irandms/junior-design/README.md

# junior-design
ECE 341 Junior Design - Final Project - Bluetooth controlled AC switch
