irandms/junior-design/Documents/Block_Diagram_and_Interfaces 1_18_18.pdf

### Block Diagram and Interfaces Bluetooth Controlled AC Switch Group 5: Jesus Narvaez, Spencer Moss and Jacob Ficker

Black Box System:

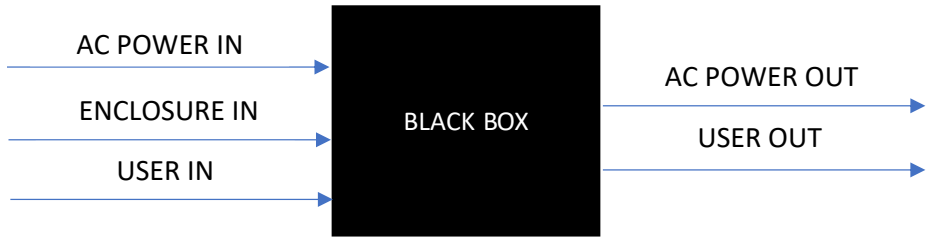
[picture p3: figure]
BLACK BOX; AC POWER IN; ENCLOSURE IN; USER IN; AC POWER OUT; USER OUT

Complete Block Diagram:

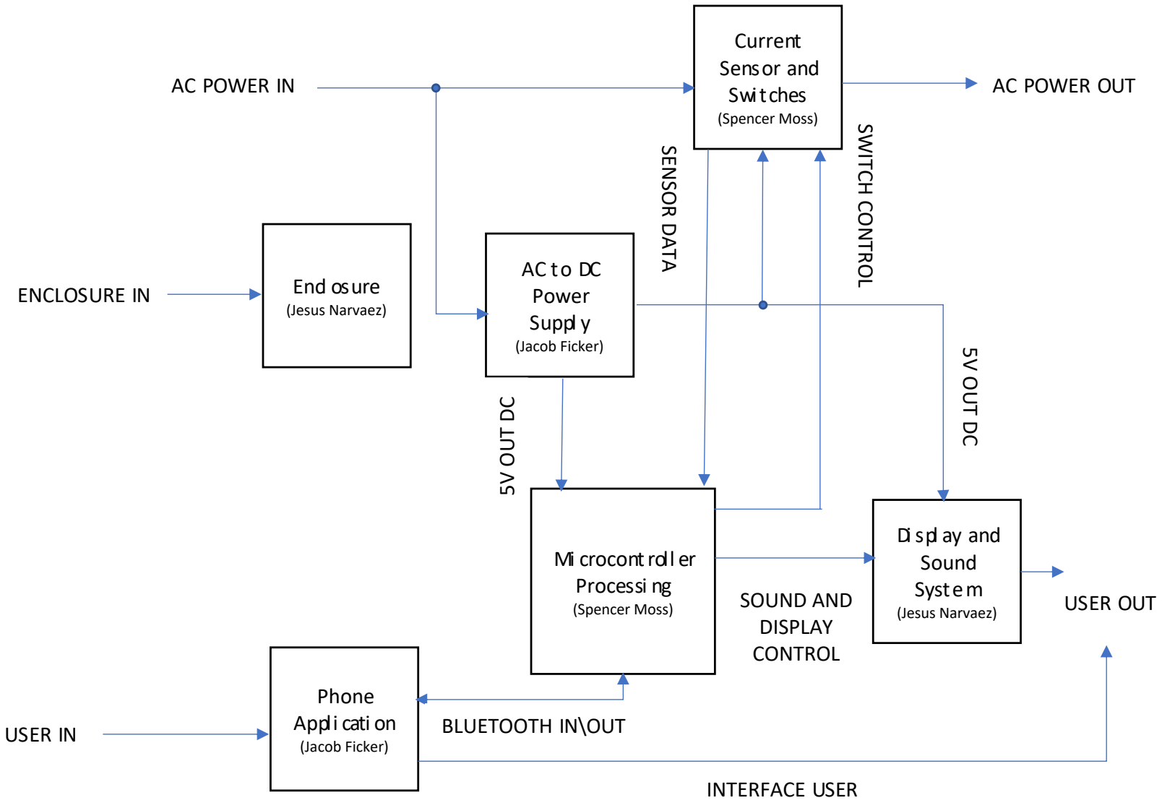
[picture p4: figure]
Phone Appli cati on; (Jacob Ficker); Mi crocont roll er Processi ng; (Spencer Moss); Encl osure; (Jesus Narvaez); Di spl ay and Sound System; AC to DC Power Suppl y; Current Sensor and Switches; USER OUT; AC POWER OUT; USER IN; ENCLOSURE IN; AC POWER IN; BLUETOOTH IN\OUT; INTERFACE USER; 5V OUT DC; SENSOR DATA; SWITCH CONTROL; SOUND AND DISPLAY CONTROL

Interface | Type | Specifics
AC In | AC Power | • Standard U.S. Power • 60 Hz • 120 VAC
AC Out, 2 channels | AC Power | • 60 Hz • 120 VAC • 5 A / 600 W limit on power draw
Enclosure Environment | Environment | • Must not allow any objects larger than 1mm in any dimension inside enclosure. • One master on/off switch
Bluetooth I/O | Digital Data / RF Communication | • IN: One 20 byte packet representing channel state and timer setting. • OUT: One 20 byte packet representing current/power consumption, 10 bytes per channel
User In | App/Display | • Must be considered easily usable by 9/10 people • Successfully transmit data 90% of the time when within range of the device
5V DC Out | DC Power | • Must supply 5V DC • Up to 1.5A DC
Switch Control | Digital Signal | • On/Off 1-bit control signal • 1 signal per output channel (2 total)
Sensor Data | Analog Signal | • Analog 0-5V signal • 2 total signals, 1 per channel
Display + Sound Control | Mixed Signal | • Digital signals to control local display (7-segment displays) of power/current • Small signal AC for audio output (0-5 V)
7-seg + Speaker | Display | • Must create audible noise and readable display for system state and timers • Must make audible sound from at least 10 meters of open space when current limit is triggered.
User Interface | App Display | • Must display current power usage by each channel within 10% • Must update power usage data at least once per minute
User Output | Display | • Displays on/off state of each channel and bluetooth pairing state with 99.9% accuracy.

Interface | Type | Specifics
| | • Displays time remaining on each timer in minutes. This feature must be accurate within five seconds of the actual time remaining.
