irandms/junior-design/ac-switch-board-minimal/ac-switch-board-minimal.pdf

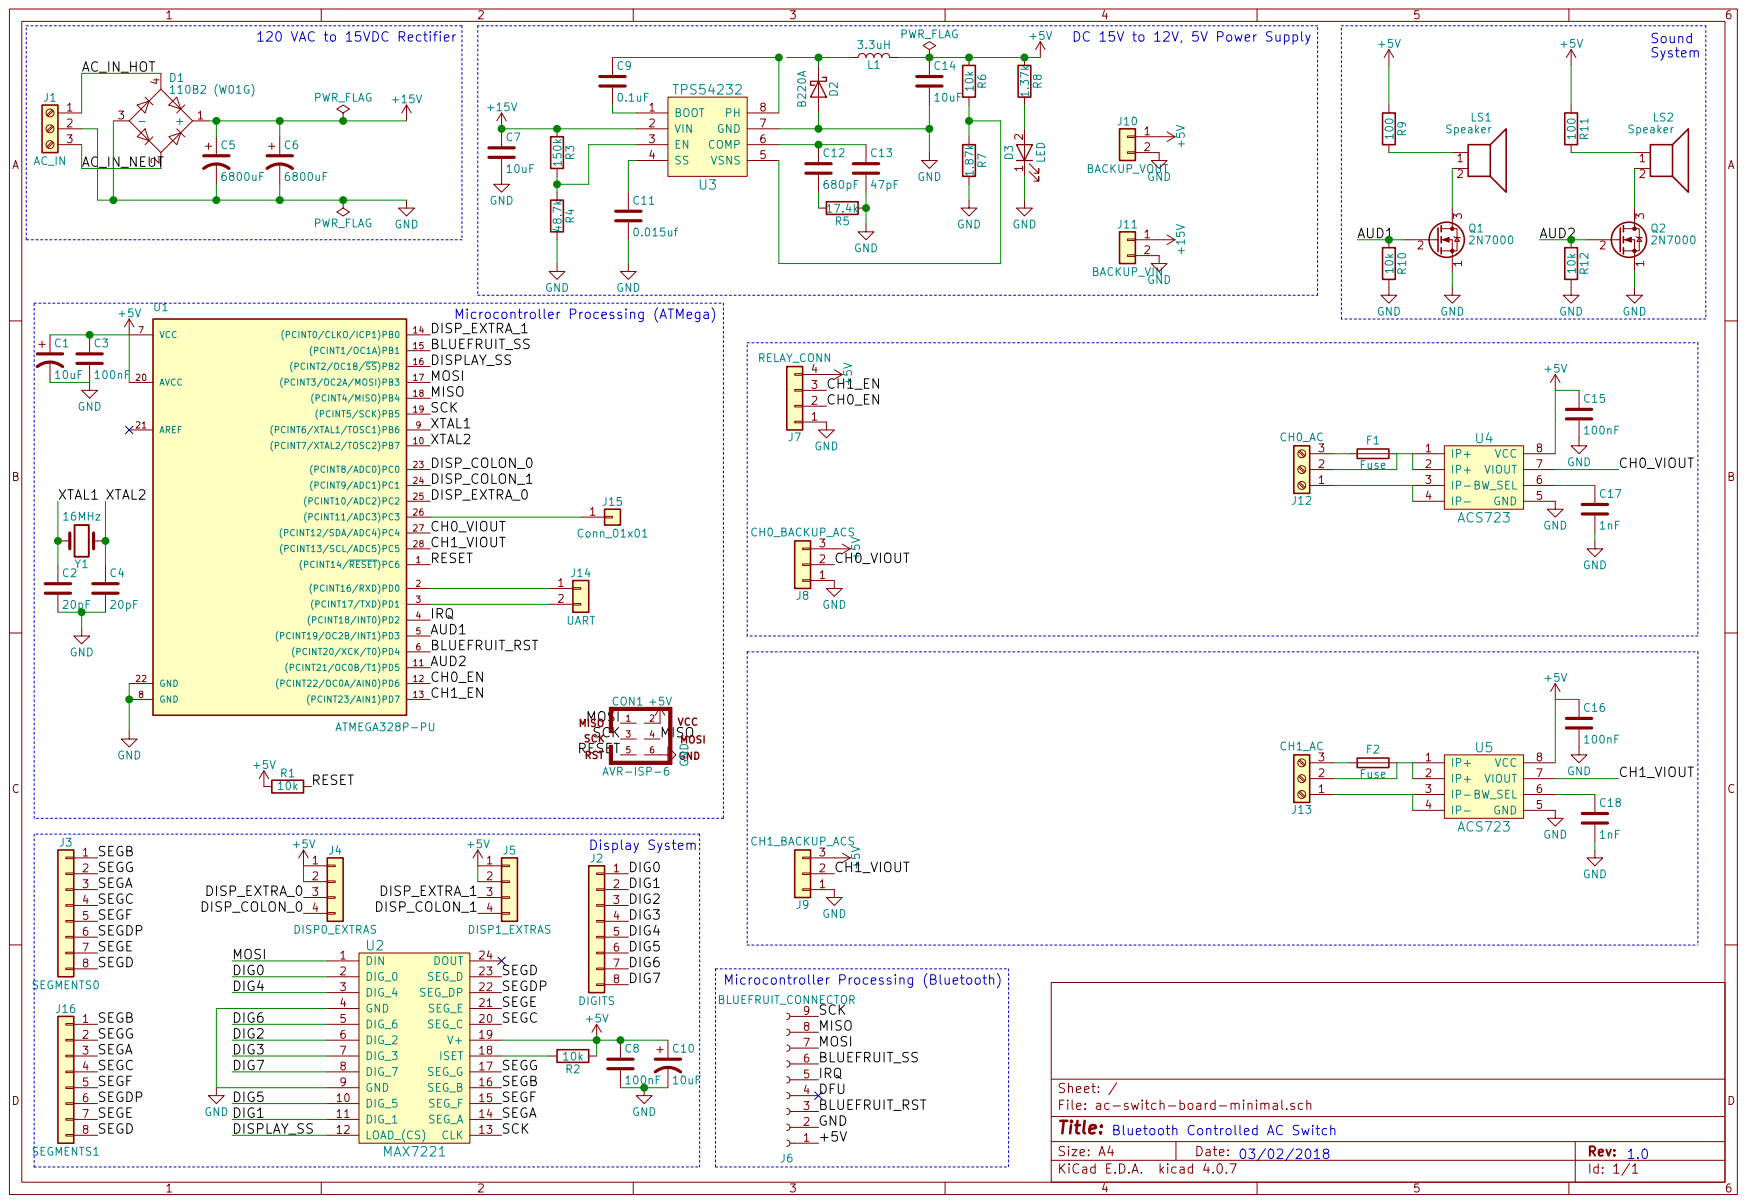
[picture p5: page 1]
