irandms/junior-design/ac-switch-board/ac-switch-board.pdf

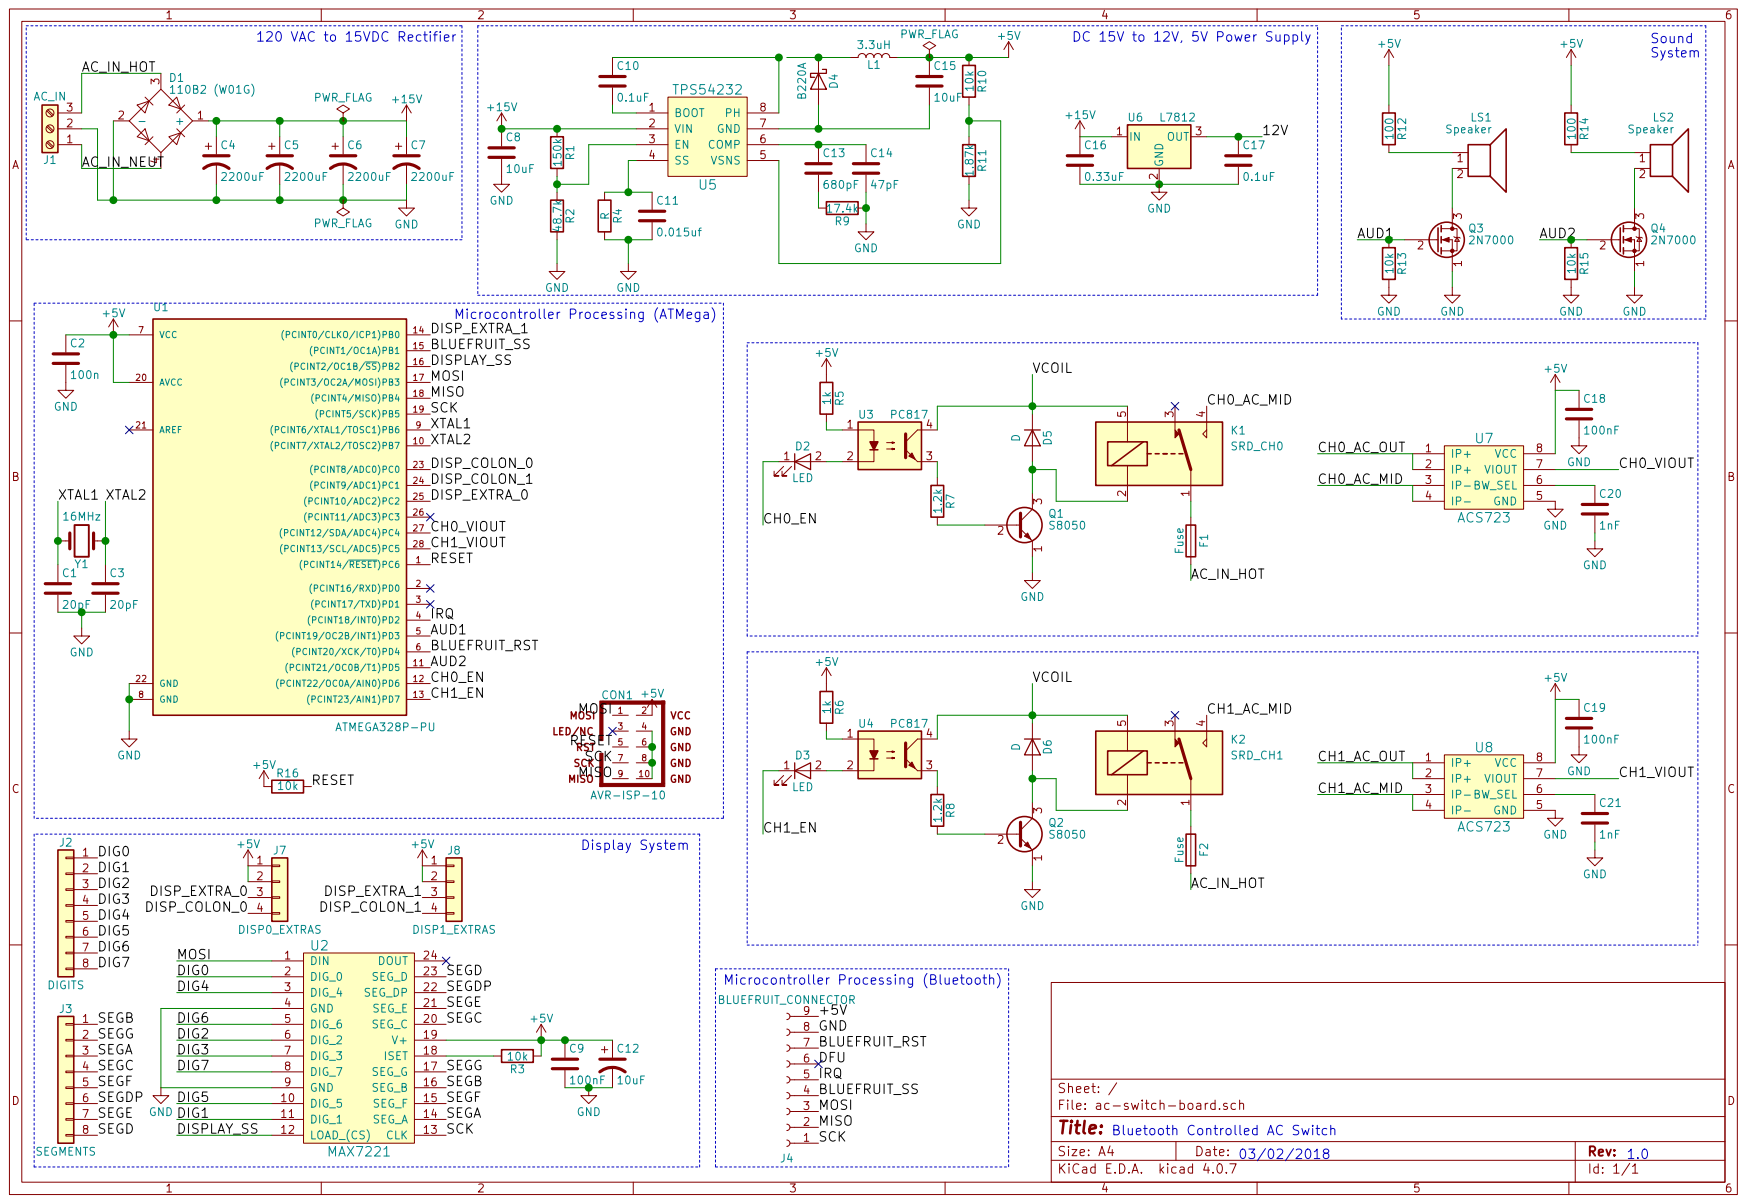
[picture p6: page 1]
