irandms/junior-design/7segboard/gerbers/7segboard-B.Cu.pdf

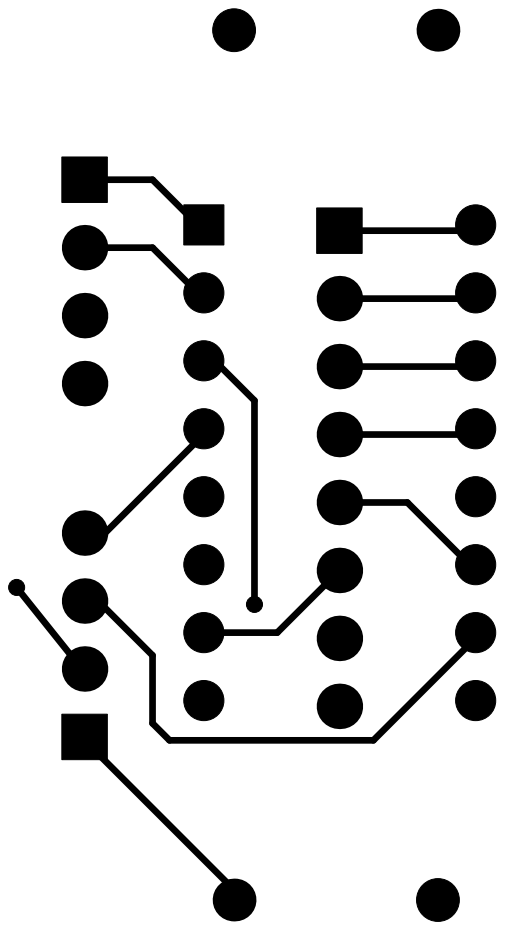
[picture p7: page 1]
