irandms/junior-design/7segboard/gerbers/7segboard-B.Mask.pdf

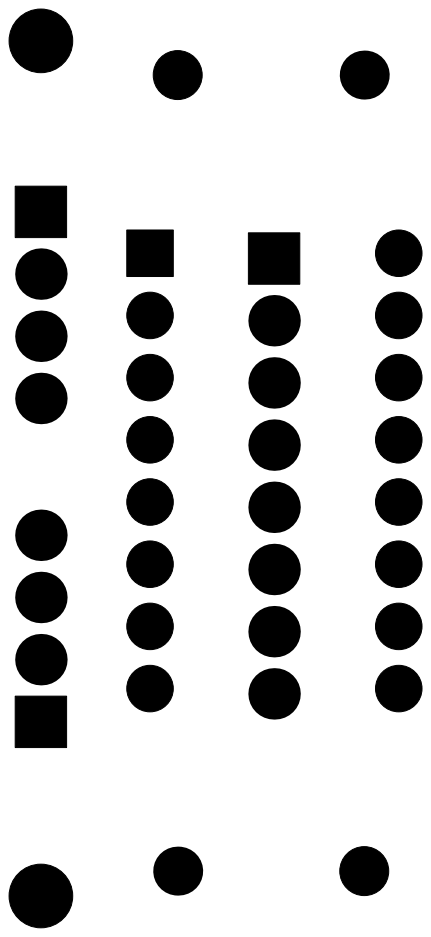
[picture p8: page 1]
