irandms/junior-design/7segboard/gerbers/7segboard-B.SilkS.pdf

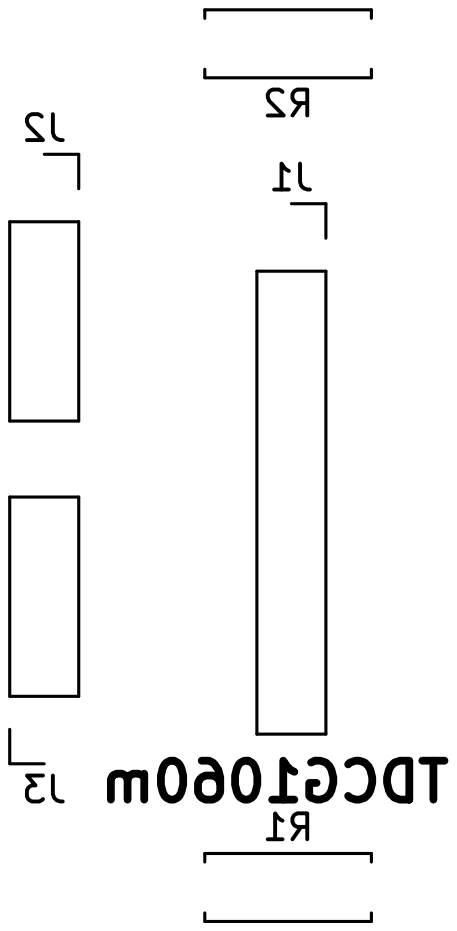
[picture p9: page 1]
