irandms/junior-design/7segboard/gerbers/7segboard-F.Cu.pdf

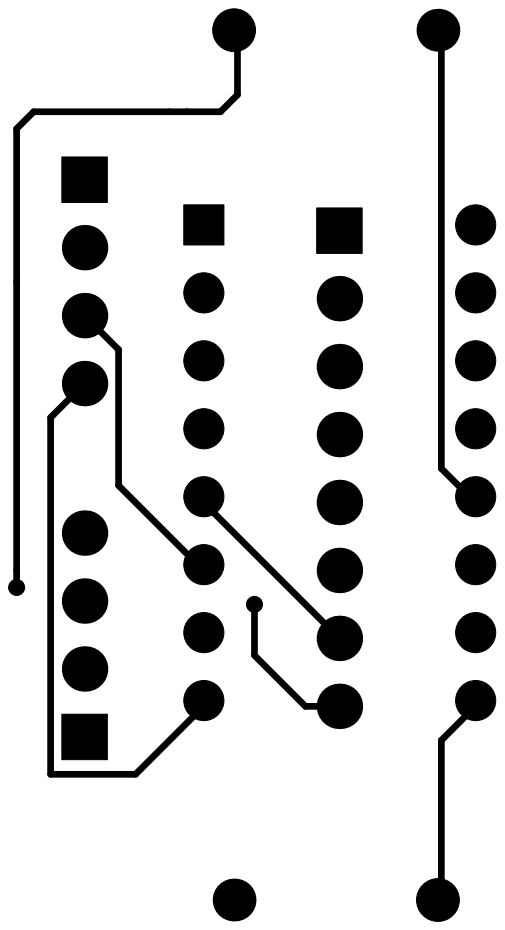
[picture p10: page 1]
