irandms/junior-design/7segboard/gerbers/7segboard-F.SilkS.pdf

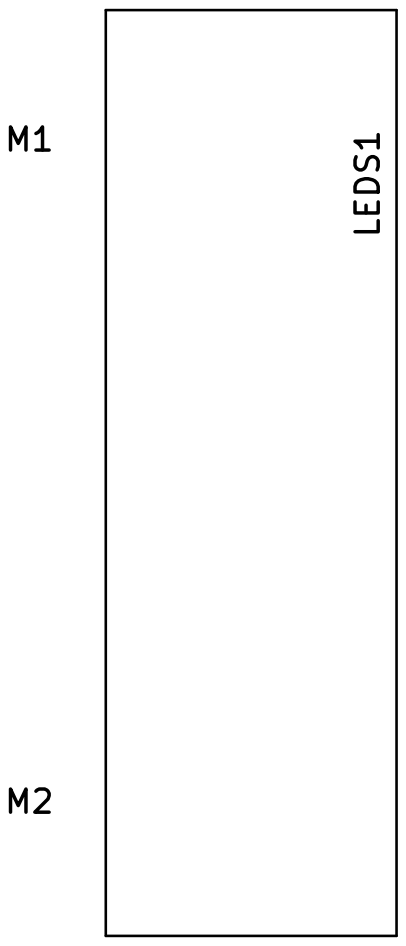
[picture p11: page 1]
