irandms/junior-design/7segboard/7segboard.kicad_pcb

## KiCad design 7segboard/7segboard.kicad_pcb (2018-03-08)

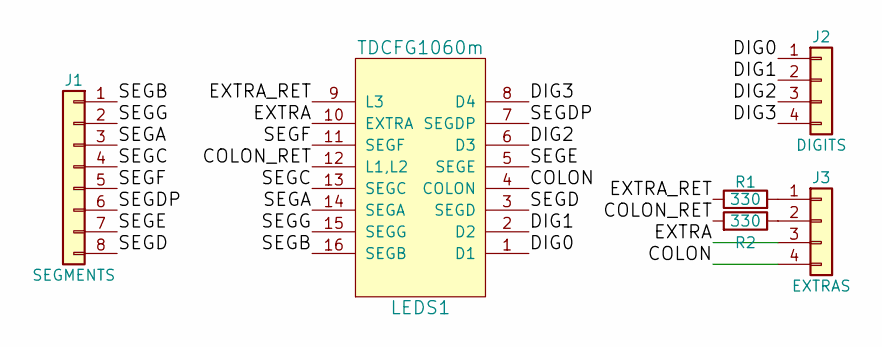
[picture p12: schematic 7segboard.sch]

Parts:
J1: SEGMENTS; Pin_Header_Straight_1x08_Pitch2.54mm
J2: DIGITS; Pin_Header_Straight_1x04_Pitch2.54mm
J3: EXTRAS; Pin_Header_Straight_1x04_Pitch2.54mm
LEDS1: TDCFG1060m; TDCG1060m
R1, R2: 330; R_Axial_DIN0207_L6.3mm_D2.5mm_P7.62mm_Horizontal

Connections:
/COLON: J3.4, LEDS1.4 (COLON)
/COLON_RET: LEDS1.12 (L1,L2), R2.2
/DIG0: J2.1, LEDS1.1 (D1)
/DIG1: J2.2, LEDS1.2 (D2)
/DIG2: J2.3, LEDS1.6 (D3)
/DIG3: J2.4, LEDS1.8 (D4)
/EXTRA: J3.3, LEDS1.10 (EXTRA)
/EXTRA_RET: LEDS1.9 (L3), R1.1
/SEGA: J1.3, LEDS1.14 (SEGA)
/SEGB: J1.1, LEDS1.16 (SEGB)
/SEGC: J1.4, LEDS1.13 (SEGC)
/SEGD: J1.8, LEDS1.3 (SEGD)
/SEGDP: J1.6, LEDS1.7 (SEGDP)
/SEGE: J1.7, LEDS1.5 (SEGE)
/SEGF: J1.5, LEDS1.11 (SEGF)
/SEGG: J1.2, LEDS1.15 (SEGG)
unnamed: J3.1, R1.2
unnamed: J3.2, R2.1

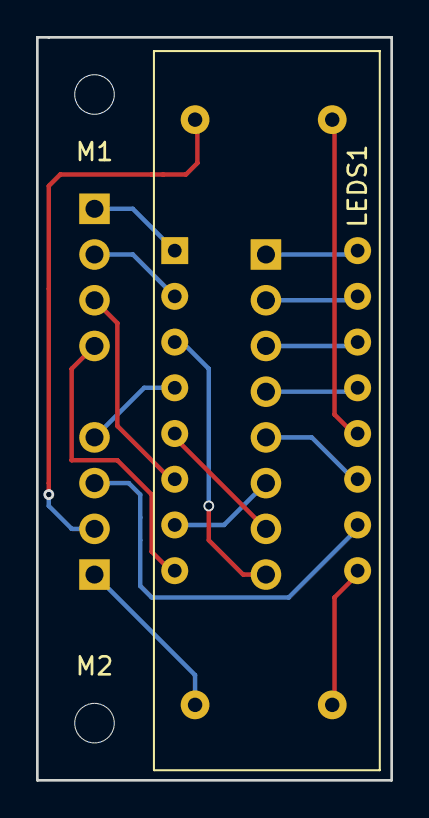
[picture p13: board 7segboard.kicad_pcb from above]

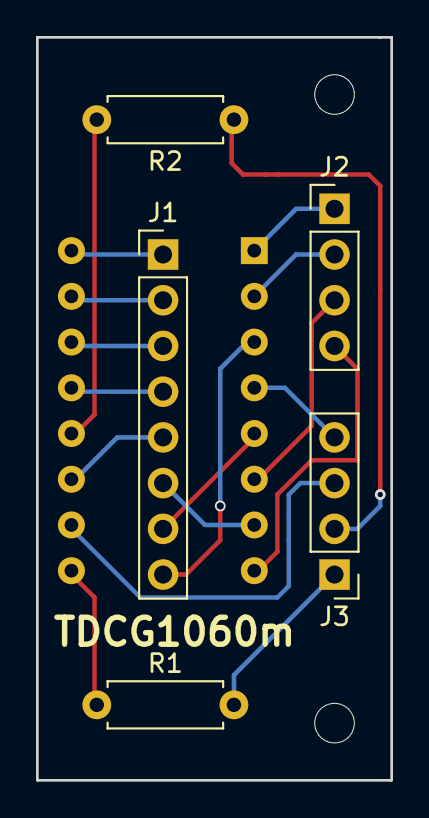
[picture p14: board 7segboard.kicad_pcb from below]

Board: 2 copper layers, 19.7 x 41.3 mm, 8 parts (5 on the bottom side), 18 nets.

Other parts of the board:
M1: M1; MountingHole_2.2mm_M2
M2: M2; MountingHole_2.2mm_M2
