irandms/junior-design/ac-switch-board-minimal/ac-switch-board-minimal.kicad_pcb

## KiCad design ac-switch-board-minimal/ac-switch-board-minimal.kicad_pcb (2018-03-08)

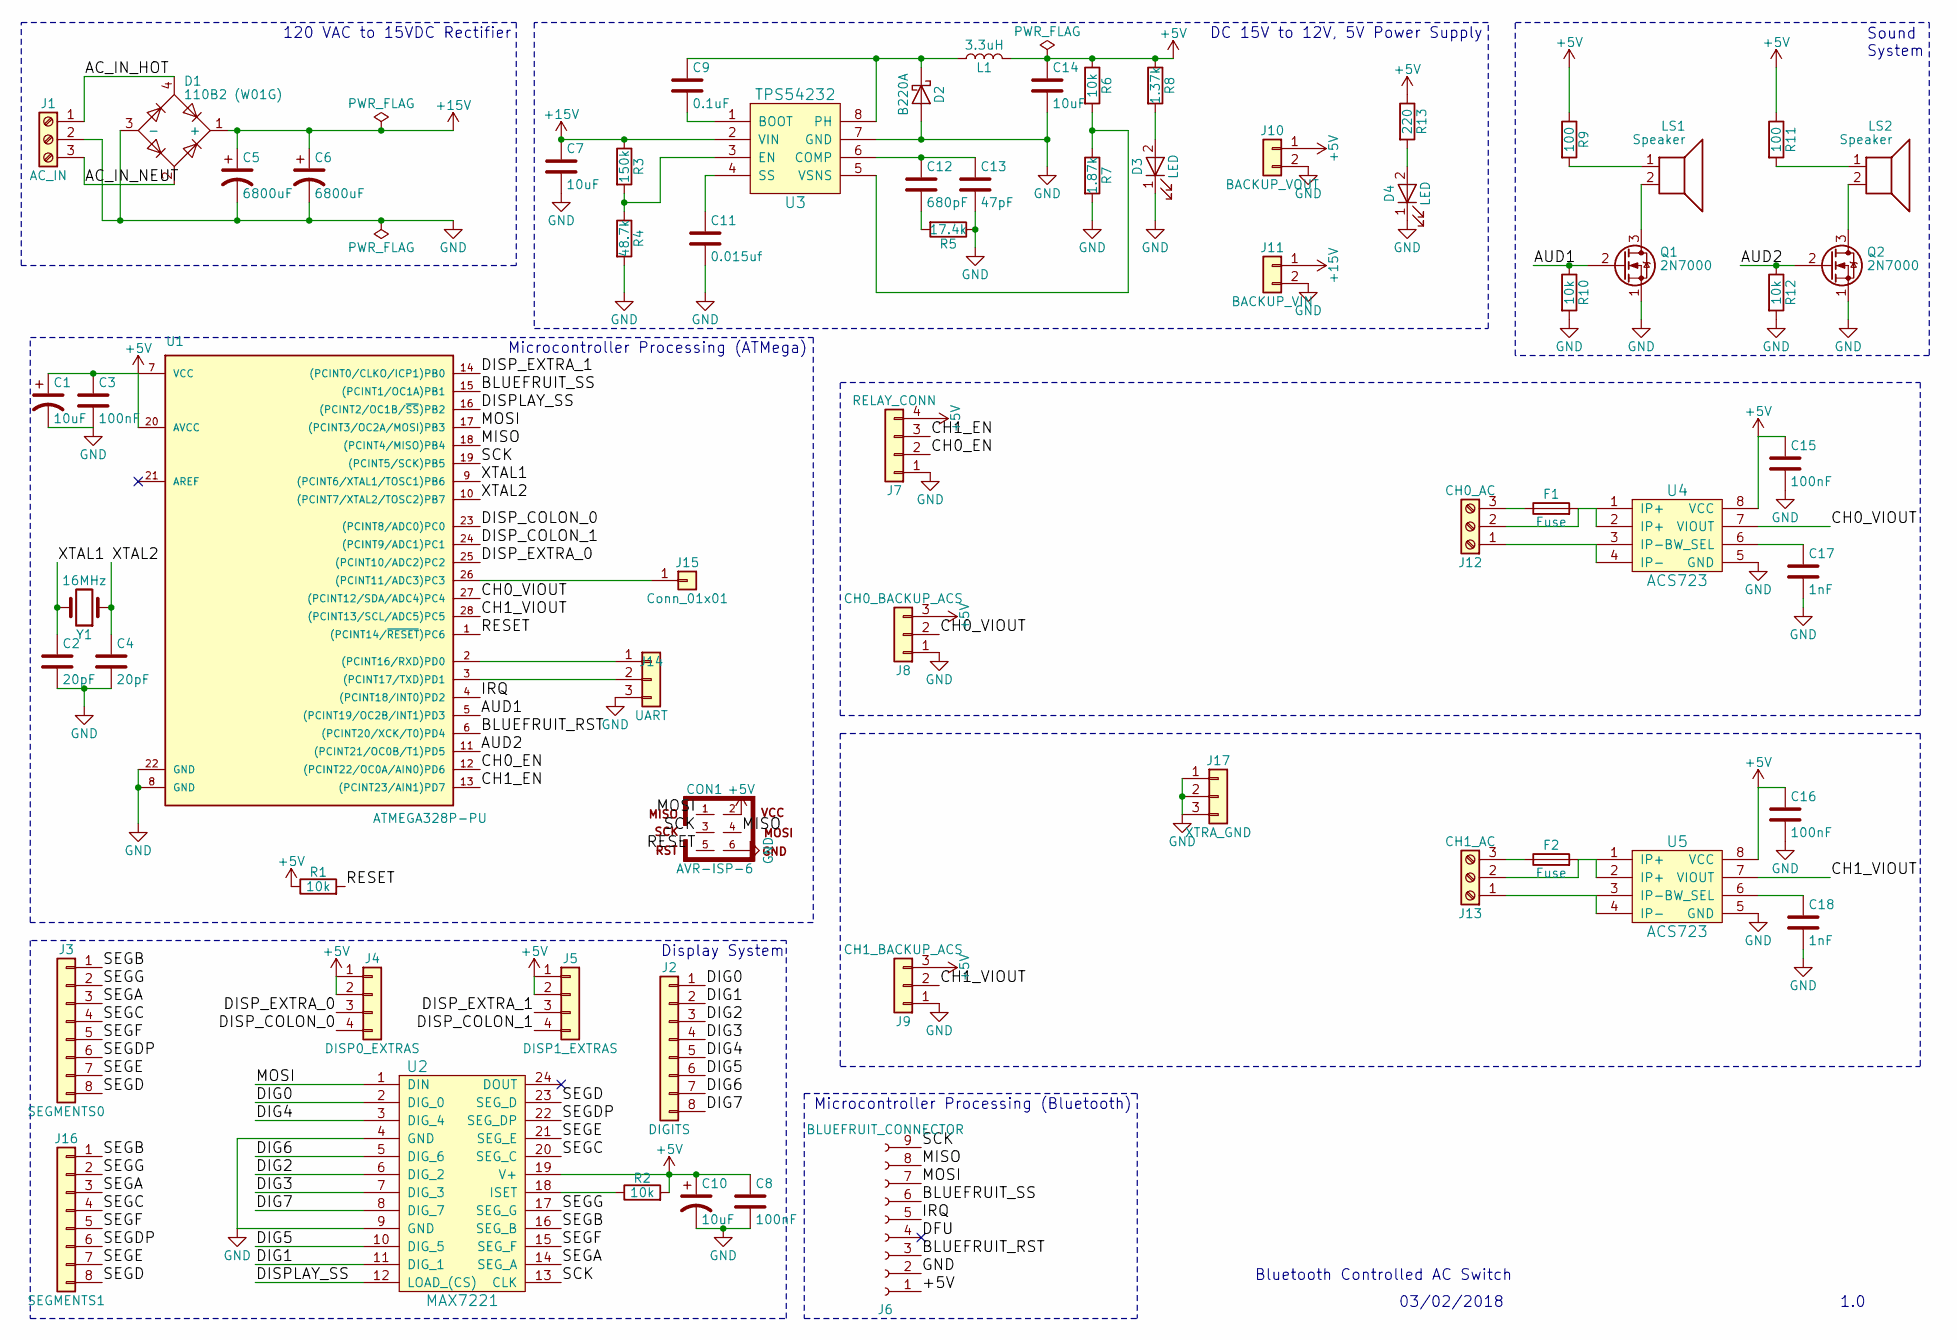
[picture p15: schematic ac-switch-board-minimal.sch]

Parts:
C1, C10: 10uF; CP_Elec_4x4.5; MPN EEE-1VA100WR; DigiKey PCE3948CT-ND
C2: 20pF; C_0603; MPN CL10C200JB8NCNC; DigiKey 1276-2220-1-ND
C3, C8, C15, C16: 100nF; C_1206_HandSoldering; MPN C1206C104K5RAC7867; DigiKey 399-1249-1-ND
C4: 20pF; C_0603
C5, C6: 6800uF; CP_Radial_D18.0mm_P7.50mm; MPN EEU-HD1V682; DigiKey P15173-ND
C7: 10uF; C_1206_HandSoldering; MPN C1206C106M3PACTU; DigiKey 399-8153-1-ND
C9: 0.1uF; C_1206_HandSoldering; MPN C1206C104K5RAC7867; DigiKey 399-1249-1-ND
C11: 0.015uf; C_0805_HandSoldering; MPN GRM2195C1H153JA01D; DigiKey 490-1643-1-ND
C12: 680pF; C_0805_HandSoldering; MPN CC0805JRNPO9BN681; DigiKey 311-1121-1-ND
C13: 47pF; C_0805_HandSoldering; MPN CC0805JRNPO9BN470; DigiKey 311-1107-1-ND
C14: 10uF; C_1206_HandSoldering; MPN CL31B106MOHNNNE; DigiKey 1276-6641-1-ND
C17, C18: 1nF; C_0805_HandSoldering; MPN C0805C102K5RACTU; DigiKey 399-1147-1-ND
CON1: AVR-ISP-6; IDC_Header_Straight_6pins
D1: 110B2 (W01G); Diode_Bridge_Round_D8.9mm; MPN W01G-E4/51; DigiKey W01G-E4/51GI-ND
D2: B220A; D_SMA; MPN B220A-13-F; DigiKey B220A-FDICT-ND
D3: LED; LED_0603_HandSoldering; MPN SML-D12V1WT86; DigiKey SML-D12V1WT86CT-ND
D4: LED; Pin_Header_Straight_1x02_Pitch2.54mm
F1, F2: Fuse; Fuseholder5x20_horiz_SemiClosed_Casing10x25mm
J1: AC_IN; AK300-3
J2: DIGITS; Pin_Header_Straight_1x08_Pitch2.54mm
J3: SEGMENTS0; Pin_Header_Straight_1x08_Pitch2.54mm
J4: DISP0_EXTRAS; Pin_Header_Straight_1x04_Pitch2.54mm
J5: DISP1_EXTRAS; Pin_Header_Straight_1x04_Pitch2.54mm
J6: BLUEFRUIT_CONNECTOR; Pin_Header_Straight_1x09_Pitch2.54mm
J7: RELAY_CONN; Pin_Header_Straight_1x04_Pitch2.54mm
J8: CH0_BACKUP_ACS; Pin_Header_Straight_1x03_Pitch2.54mm
J9: CH1_BACKUP_ACS; Pin_Header_Straight_1x03_Pitch2.54mm
J10: BACKUP_VOUT; Pin_Header_Straight_1x02_Pitch2.54mm
J11: BACKUP_VIN; Pin_Header_Straight_1x02_Pitch2.54mm
J12: CH0_AC; AK300-3
J13: CH1_AC; AK300-3
J14: UART; Pin_Header_Straight_1x03_Pitch2.54mm
J15: Conn_01x01; Pin_Header_Straight_1x01_Pitch2.54mm
J16: SEGMENTS1; Pin_Header_Straight_1x08_Pitch2.54mm
J17: XTRA_GND; Pin_Header_Straight_1x03_Pitch2.54mm
L1: 3.3uH; L_Sumida_4.9x4.9mm_diag; MPN CDRH4D28CLDNP-3R3PC; DigiKey 308-2037-1-ND
LS1, LS2: Speaker; Pin_Header_Straight_1x02_Pitch2.54mm
Q1, Q2: 2N7000; TO-92_Molded_Narrow
R1, R2, R6, R10, R12: 10k; R_0805_HandSoldering; MPN ERA-6AEB103V; DigiKey P10KDACT-ND
R3: 150k; R_0805_HandSoldering; MPN RR1220P-154-D; DigiKey RR12P150KDCT-ND
R4: 48.7k; R_0805_HandSoldering; MPN RC0805FR-0748K7L; DigiKey 311-48.7KCRCT-ND
R5: 17.4k; R_0805_HandSoldering; MPN RC0805FR-0717K4L; DigiKey 311-17.4KCRCT-ND
R7: 1.87k; R_0805_HandSoldering; MPN RC0805FR-071K87L; DigiKey 311-1.87KCRCT-ND
R8: 1.37k; R_0805_HandSoldering; MPN RC0805FR-071K37L; DigiKey 311-1.37KCRCT-ND
R9, R11: 100; R_Axial_DIN0207_L6.3mm_D2.5mm_P5.08mm_Vertical
R13: 220; R_0805_HandSoldering; MPN ESR10EZPJ221; DigiKey RHM220KCT-ND
U1: ATMEGA328P-PU; DIP-28_W7.62mm_Socket
U2: MAX7221; DIP-24_W7.62mm_Socket
U3: TPS54232; SOIC-8-N; MPN TPS54232DR; DigiKey 296-39414-1-ND
U4, U5: ACS723; SOIC-8-N; MPN ACS723LLCTR-05AB-T; DigiKey 620-1641-1-ND
Y1: 16MHz; Crystal_HC49-4H_Vertical

Connections:
+5V: C1.1, C3.1, C8.1, C10.1, C14.1, C15.1, C16.1, CON1.2, J4.1, J4.2, J5.1, J5.2, J6.1, J7.4, J8.3, J9.3, J10.1, L1.2, R1.1, R2.2, R6.1, R8.1, R9.1, R11.1, R13.1, U1.7 (VCC), U1.20 (AVCC), U2.19 (V+), U4.8 (VCC), U5.8 (VCC)
+15V: C5.1, C6.1, C7.1, D1.1 (+), J11.1, R3.1, U3.2 (VIN)
/AC_IN_HOT: D1.4, J1.1
/AC_IN_NEUT: D1.2, J1.3
/AUD1: Q1.2 (G), R10.1, U1.5 ((PCINT19/OC2B/INT1)PD3)
/AUD2: Q2.2 (G), R12.1, U1.11 ((PCINT21/OC0B/T1)PD5)
/BLUEFRUIT_RST: J6.3, U1.6 ((PCINT20/XCK/T0)PD4)
/BLUEFRUIT_SS: J6.6, U1.15 ((PCINT1/OC1A)PB1)
/CH0_EN: J7.2, U1.12 ((PCINT22/OC0A/AIN0)PD6)
/CH0_VIOUT: J8.2, U1.27 ((PCINT12/SDA/ADC4)PC4), U4.7 (VIOUT)
/CH1_EN: J7.3, U1.13 ((PCINT23/AIN1)PD7)
/CH1_VIOUT: J9.2, U1.28 ((PCINT13/SCL/ADC5)PC5), U5.7 (VIOUT)
/DFU: J6.4
/DIG0: J2.1, U2.2 (DIG_0)
/DIG1: J2.2, U2.11 (DIG_1)
/DIG2: J2.3, U2.6 (DIG_2)
/DIG3: J2.4, U2.7 (DIG_3)
/DIG4: J2.5, U2.3 (DIG_4)
/DIG5: J2.6, U2.10 (DIG_5)
/DIG6: J2.7, U2.5 (DIG_6)
/DIG7: J2.8, U2.8 (DIG_7)
/DISPLAY_SS: U1.16 ((PCINT2/OC1B/~SS~)PB2), U2.12 (LOAD_(CS))
/DISP_COLON_0: J4.4, U1.23 ((PCINT8/ADC0)PC0)
/DISP_COLON_1: J5.4, U1.24 ((PCINT9/ADC1)PC1)
/DISP_EXTRA_0: J4.3, U1.25 ((PCINT10/ADC2)PC2)
/DISP_EXTRA_1: J5.3, U1.14 ((PCINT0/CLKO/ICP1)PB0)
/IRQ: J6.5, U1.4 ((PCINT18/INT0)PD2)
/RESET: CON1.5, R1.2, U1.1 ((PCINT14/~RESET~)PC6)
/SCK: CON1.3, J6.9, U1.19 ((PCINT5/SCK)PB5), U2.13 (CLK)
/SEGA: J3.3, J16.3, U2.14 (SEG_A)
/SEGB: J3.1, J16.1, U2.16 (SEG_B)
/SEGC: J3.4, J16.4, U2.20 (SEG_C)
/SEGD: J3.8, J16.8, U2.23 (SEG_D)
/SEGDP: J3.6, J16.6, U2.22 (SEG_DP)
/SEGE: J3.7, J16.7, U2.21 (SEG_E)
/SEGF: J3.5, J16.5, U2.15 (SEG_F)
/SEGG: J3.2, J16.2, U2.17 (SEG_G)
/XTAL1: C2.1, U1.9 ((PCINT6/XTAL1/TOSC1)PB6), Y1.2
/XTAL2: C4.1, U1.10 ((PCINT7/XTAL2/TOSC2)PB7), Y1.1
GND: C1.2, C2.2, C3.2, C4.2, C5.2, C6.2, C7.2, C8.2, C10.2, C11.2, C13.2, C14.2, C15.2, C16.2, C17.2, C18.2, CON1.6, D1.3 (-), D2.2 (A), D3.1 (K), D4.1 (K), J1.2, J6.2, J7.1, J8.1, J9.1, J10.2, J11.2, J14.3, J17.1, J17.2, J17.3, Q1.1 (S), Q2.1 (S), R4.2, R5.1, R7.2, R10.2, R12.2, U1.8 (GND), U1.22 (GND), U2.4 (GND), U2.9 (GND), U3.7 (GND), U4.5 (GND), U5.5 (GND)
unnamed: C9.1, D2.1 (K), L1.1, U3.8 (PH)
unnamed: C9.2, U3.1 (BOOT)
unnamed: C11.1, U3.4 (SS)
unnamed: C12.1, C13.1, U3.6 (COMP)
unnamed: C12.2, R5.2
unnamed: C17.1, U4.6 (BW_SEL)
unnamed: C18.1, U5.6 (BW_SEL)
unnamed: D3.2 (A), R8.2
unnamed: D4.2 (A), R13.2
unnamed: F1.1, J12.3
unnamed: F1.2, J12.2, U4.1 (IP+), U4.2 (IP+)
unnamed: F2.1, J13.3
unnamed: F2.2, J13.2, U5.1 (IP+), U5.2 (IP+)
unnamed: J12.1, U4.3 (IP-), U4.4 (IP-)
unnamed: J13.1, U5.3 (IP-), U5.4 (IP-)
unnamed: J14.1, U1.2 ((PCINT16/RXD)PD0)
unnamed: J14.2, U1.3 ((PCINT17/TXD)PD1)
unnamed: J15.1, U1.26 ((PCINT11/ADC3)PC3)
unnamed: LS1.1, R9.2
unnamed: LS1.2, Q1.3 (D)
unnamed: LS2.1, R11.2
unnamed: LS2.2, Q2.3 (D)
unnamed: R2.1, U2.18 (ISET)
unnamed: R3.2, R4.1, U3.3 (EN)
unnamed: R6.2, R7.1, U3.5 (VSNS)

Notes on the sheet:
Bluetooth Controlled AC Switch
03/02/2018
1.0
Microcontroller Processing (ATMega)
Microcontroller Processing (Bluetooth)
Display System
Sound System
120 VAC to 15VDC Rectifier
DC 15V to 12V, 5V Power Supply

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
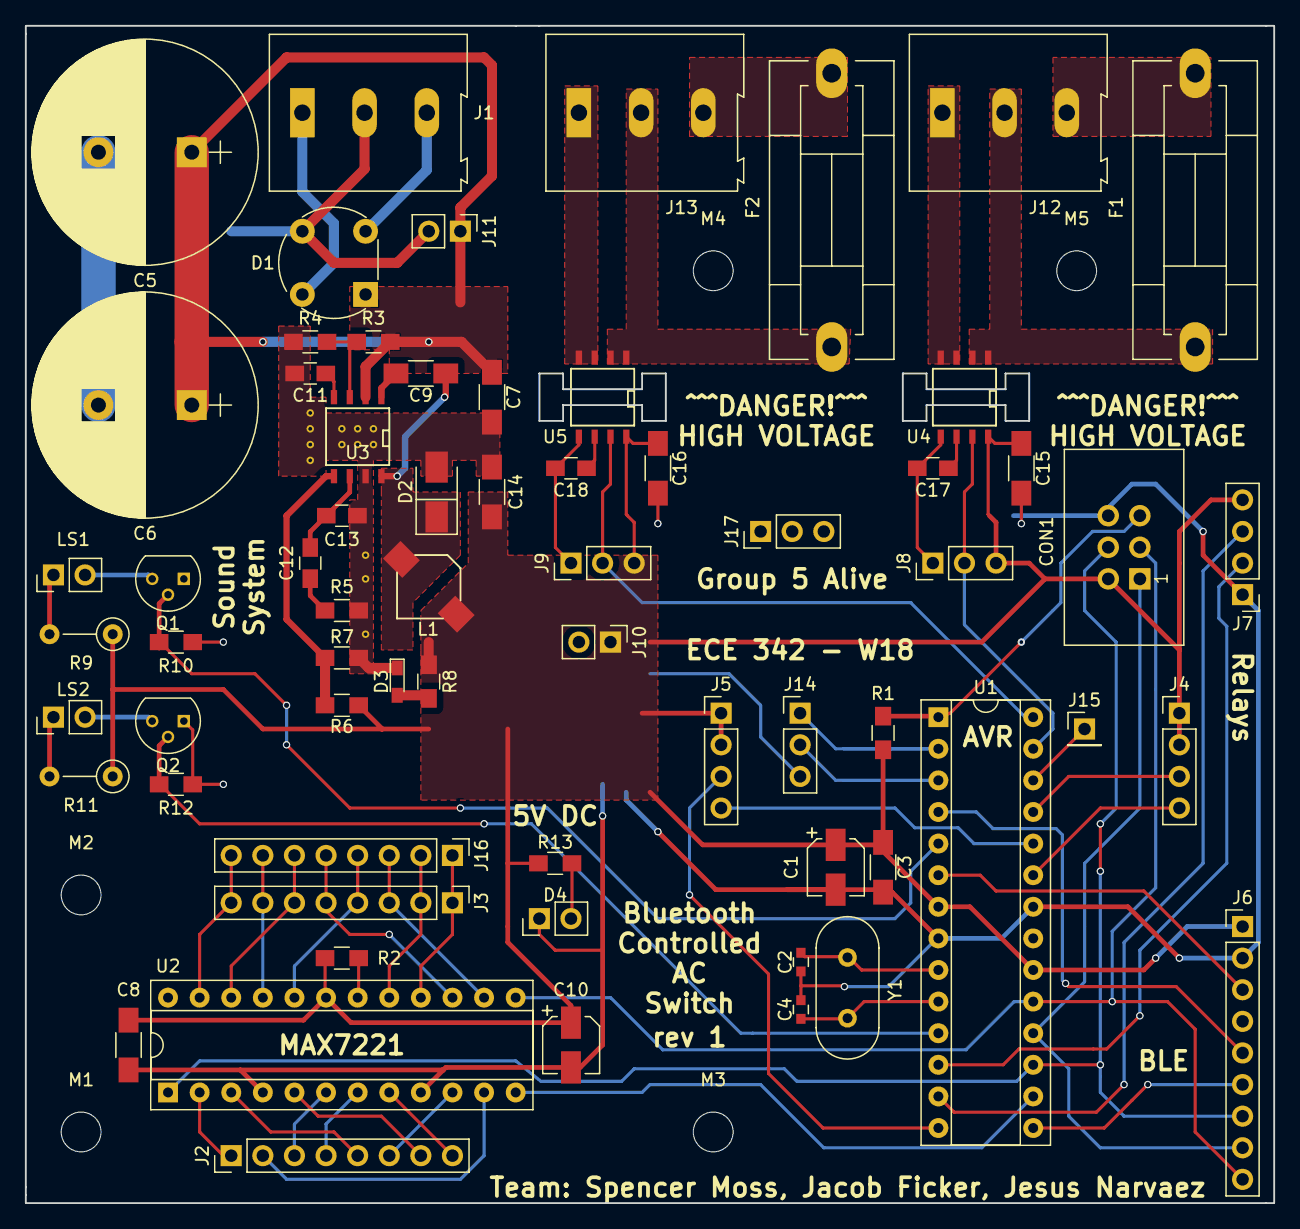
[picture p16: board ac-switch-board-minimal.kicad_pcb from above]

Board: 2 copper layers, 100.3 x 94.6 mm, 71 parts (0 on the bottom side), 66 nets.

Other parts of the board:
M1, M2, M3, M4, M5: MountingHole_3.2mm_M3
