irandms/junior-design/ac-switch-board/ac-switch-board.kicad_pcb

## KiCad design ac-switch-board/ac-switch-board.kicad_pcb (2018-02-09)

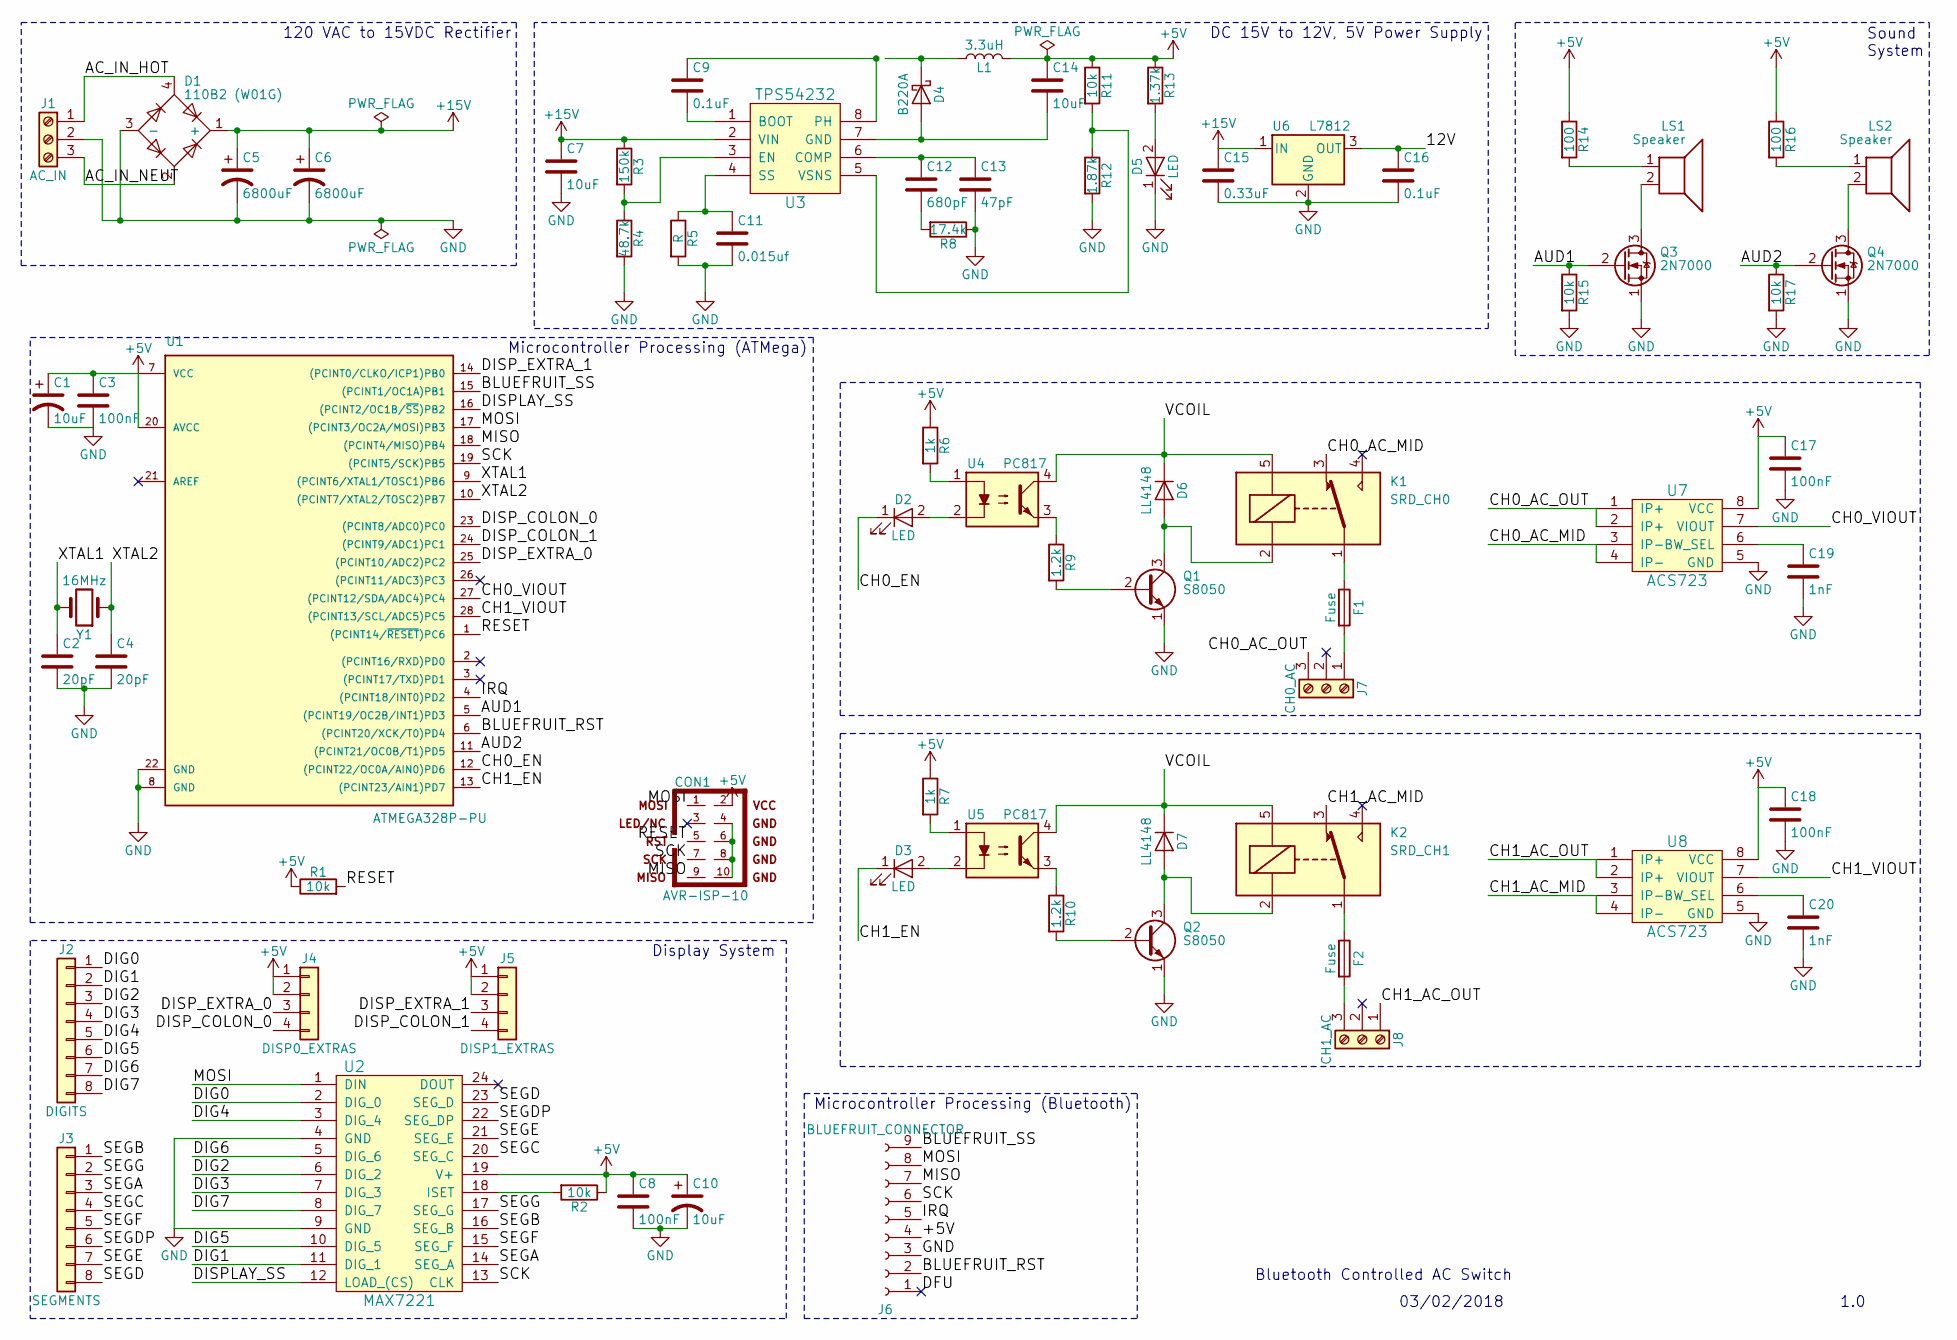
[picture p17: schematic ac-switch-board.sch]

Parts:
C1, C10: 10uF; CP_Elec_4x4.5
C2, C4: 20pF; C_0603
C3, C8, C17, C18: 100nF; C_1206_HandSoldering
C5, C6: 6800uF; CP_Radial_D18.0mm_P7.50mm
C7, C14: 10uF; C_1206_HandSoldering
C9: 0.1uF; C_1206_HandSoldering
C11: 0.015uf; C_0805_HandSoldering
C12: 680pF; C_0805_HandSoldering
C13: 47pF; C_0805_HandSoldering
C15: 0.33uF; C_0805_HandSoldering
C16: 0.1uF; C_0805_HandSoldering
C19, C20: 1nF; C_0805_HandSoldering
CON1: AVR-ISP-10; IDC_Header_Straight_10pins
D1: 110B2 (W01G); Diode_Bridge_Round_D8.9mm
D2, D3, D5: LED; LED_0603_HandSoldering; DigiKey SML-D12V1WT86
D4: B220A; D_SMA
D6, D7: LL4148; D_MiniMELF
F1, F2: Fuse; Fuseholder5x20_horiz_SemiClosed_Casing10x25mm
J1: AC_IN; AK300-3
J2: DIGITS; Pin_Header_Straight_1x08_Pitch2.54mm
J3: SEGMENTS; Pin_Header_Straight_1x08_Pitch2.54mm
J4: DISP0_EXTRAS; Pin_Header_Straight_1x04_Pitch2.54mm
J5: DISP1_EXTRAS; Pin_Header_Straight_1x04_Pitch2.54mm
J6: BLUEFRUIT_CONNECTOR; Pin_Header_Straight_1x09_Pitch2.54mm
J7: CH0_AC; AK300-3
J8: CH1_AC; AK300-3
K1: SRD_CH0; Relay_SPDT_SANYOU_SRD_Series_Form_C
K2: SRD_CH1; Relay_SPDT_SANYOU_SRD_Series_Form_C
L1: 3.3uH; L_Sumida_4.9x4.9mm_diag
LS1, LS2: Speaker; Pin_Header_Straight_1x02_Pitch2.54mm
Q1, Q2: S8050; TO-92_Molded_Narrow
Q3, Q4: 2N7000; TO-92_Molded_Narrow
R1, R2, R11, R15, R17: 10k; R_0805_HandSoldering
R3: 150k; R_0805_HandSoldering
R4: 48.7k; R_0805_HandSoldering
R5: R; R_0805_HandSoldering
R6, R7: 1k; R_0805_HandSoldering
R8: 17.4k; R_0805_HandSoldering
R9, R10: 1.2k; R_0805_HandSoldering
R12: 1.87k; R_0805_HandSoldering
R13: 1.37k; R_0805_HandSoldering
R14, R16: 100; R_Axial_DIN0207_L6.3mm_D2.5mm_P10.16mm_Horizontal
U1: ATMEGA328P-PU; DIP-28_W7.62mm_Socket
U2: MAX7221; DIP-24_W7.62mm_Socket
U3: TPS54232; SOIC-8-N
U4, U5: PC817; DIP-4_W7.62mm
U6: L7812; TO-220_Vertical
U7, U8: ACS723; SOIC-8-N
Y1: 16MHz; Crystal_HC49-4H_Vertical

Connections:
+5V: C1.1, C3.1, C8.1, C10.1, C14.1, C17.1, C18.1, CON1.2, J4.1, J4.2, J5.1, J5.2, J6.4, L1.2, R1.1, R2.1, R6.1, R7.1, R11.1, R13.1, R14.1, R16.1, U1.7 (VCC), U1.20 (AVCC), U2.19 (V+), U7.8 (VCC), U8.8 (VCC)
+15V: C5.1, C6.1, C7.1, C15.1, D1.1 (+), R3.1, U3.2 (VIN), U6.1 (IN)
/12V: C16.1, U6.3 (OUT)
/AC_IN_HOT: D1.4, J1.1
/AC_IN_NEUT: D1.2, J1.3
/AUD1: Q3.2 (G), R15.1, U1.5 ((PCINT19/OC2B/INT1)PD3)
/AUD2: Q4.2 (G), R17.1, U1.11 ((PCINT21/OC0B/T1)PD5)
/BLUEFRUIT_RST: J6.2, U1.6 ((PCINT20/XCK/T0)PD4)
/BLUEFRUIT_SS: J6.9, U1.15 ((PCINT1/OC1A)PB1)
/CH0_AC_MID: K1.3, U7.3 (IP-), U7.4 (IP-)
/CH0_AC_OUT: J7.3, U7.1 (IP+), U7.2 (IP+)
/CH0_EN: D2.1 (K), U1.12 ((PCINT22/OC0A/AIN0)PD6)
/CH0_VIOUT: U1.27 ((PCINT12/SDA/ADC4)PC4), U7.7 (VIOUT)
/CH1_AC_MID: K2.3, U8.3 (IP-), U8.4 (IP-)
/CH1_AC_OUT: J8.1, U8.1 (IP+), U8.2 (IP+)
/CH1_EN: D3.1 (K), U1.13 ((PCINT23/AIN1)PD7)
/CH1_VIOUT: U1.28 ((PCINT13/SCL/ADC5)PC5), U8.7 (VIOUT)
/DFU: J6.1
/DIG0: J2.1, U2.2 (DIG_0)
/DIG1: J2.2, U2.11 (DIG_1)
/DIG2: J2.3, U2.6 (DIG_2)
/DIG3: J2.4, U2.7 (DIG_3)
/DIG4: J2.5, U2.3 (DIG_4)
/DIG5: J2.6, U2.10 (DIG_5)
/DIG6: J2.7, U2.5 (DIG_6)
/DIG7: J2.8, U2.8 (DIG_7)
/DISPLAY_SS: U1.16 ((PCINT2/OC1B/~SS~)PB2), U2.12 (LOAD_(CS))
/DISP_COLON_0: J4.4, U1.23 ((PCINT8/ADC0)PC0)
/DISP_COLON_1: J5.4, U1.24 ((PCINT9/ADC1)PC1)
/DISP_EXTRA_0: J4.3, U1.25 ((PCINT10/ADC2)PC2)
/DISP_EXTRA_1: J5.3, U1.14 ((PCINT0/CLKO/ICP1)PB0)
/IRQ: J6.5, U1.4 ((PCINT18/INT0)PD2)
/MISO: CON1.9, J6.7, U1.18 ((PCINT4/MISO)PB4)
/MOSI: CON1.1, J6.8, U1.17 ((PCINT3/OC2A/MOSI)PB3), U2.1 (DIN)
/RESET: CON1.5, R1.2, U1.1 ((PCINT14/~RESET~)PC6)
/SCK: CON1.7, J6.6, U1.19 ((PCINT5/SCK)PB5), U2.13 (CLK)
/SEGA: J3.3, U2.14 (SEG_A)
/SEGB: J3.1, U2.16 (SEG_B)
/SEGC: J3.4, U2.20 (SEG_C)
/SEGD: J3.8, U2.23 (SEG_D)
/SEGDP: J3.6, U2.22 (SEG_DP)
/SEGE: J3.7, U2.21 (SEG_E)
/SEGF: J3.5, U2.15 (SEG_F)
/SEGG: J3.2, U2.17 (SEG_G)
/VCOIL: D6.1 (K), D7.1 (K), K1.5, K2.5, U4.4, U5.4
/XTAL1: C2.1, U1.9 ((PCINT6/XTAL1/TOSC1)PB6), Y1.2
/XTAL2: C4.1, U1.10 ((PCINT7/XTAL2/TOSC2)PB7), Y1.1
GND: C1.2, C2.2, C3.2, C4.2, C5.2, C6.2, C7.2, C8.2, C10.2, C11.2, C13.2, C15.2, C16.2, C17.2, C18.2, C19.2, C20.2, D1.3 (-), D5.1 (K), J1.2, J6.3, Q1.1 (E), Q2.1 (E), Q3.1 (S), Q4.1 (S), R4.2, R5.2, R8.1, R12.2, R15.2, R17.2, U1.8 (GND), U1.22 (GND), U2.4 (GND), U2.9 (GND), U6.2 (GND), U7.5 (GND), U8.5 (GND)
unnamed: C9.1, U3.8 (PH)
unnamed: C9.2, U3.1 (BOOT)
unnamed: C11.1, R5.1, U3.4 (SS)
unnamed: C12.1, C13.1, U3.6 (COMP)
unnamed: C12.2, R8.2
unnamed: C14.2, D4.2 (A), U3.7 (GND)
unnamed: C19.1, U7.6 (BW_SEL)
unnamed: C20.1, U8.6 (BW_SEL)
unnamed: CON1.4, CON1.6, CON1.8, CON1.10
unnamed: D2.2 (A), U4.2
unnamed: D3.2 (A), U5.2
unnamed: D4.1 (K), L1.1
unnamed: D5.2 (A), R13.2
unnamed: D6.2 (A), K1.2, Q1.3 (C)
unnamed: D7.2 (A), K2.2, Q2.3 (C)
unnamed: F1.1, K1.1
unnamed: F1.2, J7.1
unnamed: F2.1, K2.1
unnamed: F2.2, J8.3
unnamed: LS1.1, R14.2
unnamed: LS1.2, Q3.3 (D)
unnamed: LS2.1, R16.2
unnamed: LS2.2, Q4.3 (D)
unnamed: Q1.2 (B), R9.2
unnamed: Q2.2 (B), R10.2
unnamed: R2.2, U2.18 (ISET)
unnamed: R3.2, R4.1, U3.3 (EN)
unnamed: R6.2, U4.1
unnamed: R7.2, U5.1
unnamed: R9.1, U4.3
unnamed: R10.1, U5.3
unnamed: R11.2, R12.1, U3.5 (VSNS)

Notes on the sheet:
Bluetooth Controlled AC Switch
03/02/2018
1.0
Microcontroller Processing (ATMega)
Microcontroller Processing (Bluetooth)
Display System
Sound System
120 VAC to 15VDC Rectifier
DC 15V to 12V, 5V Power Supply

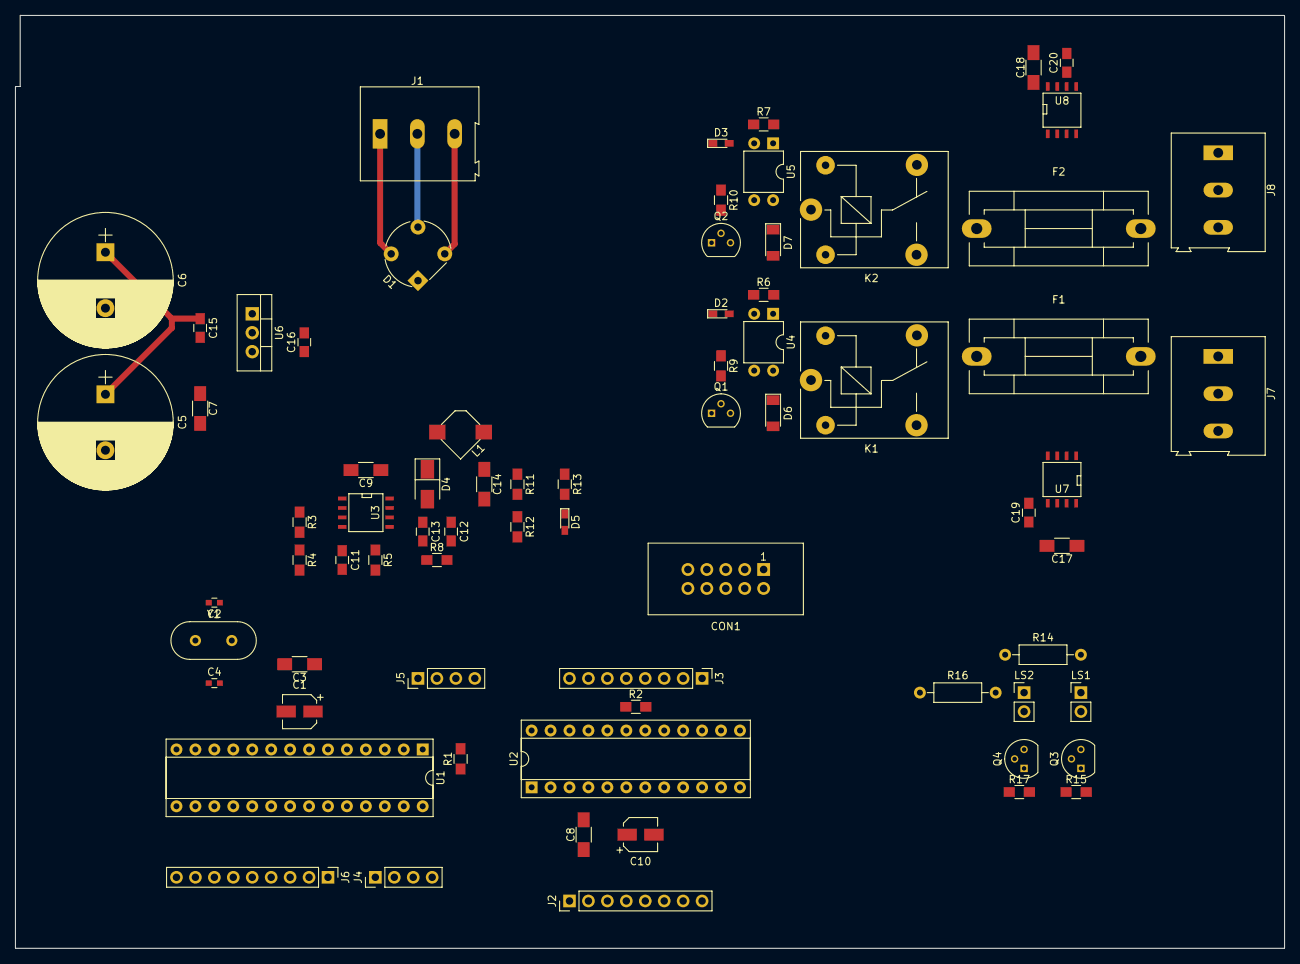
[picture p18: board ac-switch-board.kicad_pcb from above]

Board: 2 copper layers, 170.2 x 125.1 mm, 73 parts (0 on the bottom side), 79 nets.
