irandms/junior-design/(commit log)

2017-11-19 Adding links to some possible materials and resources
2017-11-30 Updated materials list
2018-01-25 Timer is working well with relay control
2018-01-25 Create Bill of Materials (Tentative)
2018-02-03 Integrated AC Current Sense and Control, Sound System, Timer code
2018-02-03 Board design things
    [_saved_ac-switch-board.sch, ac-switch-board.kicad_pcb, ac-switch-board.sch]
2018-02-03 Moved speakers to B channels of their timers, moved toggle to software interrupt. Added display code, working with maxim and 7segs
2018-02-09 Updated board, added datasheets
    [7segboard-B.Cu.gbr, 7segboard-B.Mask.gbr, 7segboard-B.SilkS.gbr, 7segboard-Edge.Cuts.gbr, 7segboard-F.Cu.gbr, 7segboard-F.Mask.gbr, 7segboard-F.SilkS.gbr, 7segboard-NPTH.drl]
2018-02-09 board progress
    [ac-switch-board-minimal.kicad_pcb, ac-switch-board-minimal.sch]
2018-02-10 board completely routed
    [ac-switch-board-minimal-B.Cu.gbr, ac-switch-board-minimal-B.Mask.gbr, ac-switch-board-minimal-B.SilkS.gbr, ac-switch-board-minimal-Edge.Cuts.gbr, ac-switch-board-minimal-F.Cu.gbr, ac-switch-board-minimal-F.Mask.gbr, ac-switch-board-minimal-F.SilkS.gbr, ac-switch-board-minimal.drl]
2018-02-10 Added silkscreen info
    [ac-switch-board-minimal-B.Cu.gbr, ac-switch-board-minimal-B.Mask.gbr, ac-switch-board-minimal-B.SilkS.gbr, ac-switch-board-minimal-Edge.Cuts.gbr, ac-switch-board-minimal-F.Cu.gbr, ac-switch-board-minimal-F.Mask.gbr, ac-switch-board-minimal-F.SilkS.gbr, ac-switch-board-minimal-NPTH.drl]
2018-02-13 Refactored some code, more integration work. Display system can now show timer duration
2018-02-13 More small board tweaks
    [ac-switch-board-B.Cu.gbr, ac-switch-board-B.Mask.gbr, ac-switch-board-B.SilkS.gbr, ac-switch-board-Edge.Cuts.gbr, ac-switch-board-F.Cu.gbr, ac-switch-board-F.Mask.gbr, ac-switch-board-F.SilkS.gbr, ac-switch-board-minimal-B.Cu.gbr]
2018-02-16 Board work
    [ac-switch-board-minimal.kicad_pcb, ac-switch-board-minimal.sch]
2018-03-02 App Code
    These are just the java files. The gradle scripts are not included, but they need to be configured correctly.
    [MainActivity.java]
2018-03-08 Board things, including errata list for next version
    [ac-switch-board-minimal-a.csv, ac-switch-board-minimal-aa.csv, ac-switch-board-minimal-digikey.csv, ac-switch-board-minimal.csv, ac-switch-board-minimal.kicad_pcb, ac-switch-board-minimal.sch]
2018-03-08 board adds
    [7segboard.kicad_pcb]
2018-03-10 Cleanup bluetooth, recalibrated for new ACS723 sensors, fixed issues with display mode showing colon after timer expiration
    [Channel.cpp, Channel.h, sketch_jan24a.ino]
